curiouselectric/solarBauble/Solar Bauble - Instructions/SolarBauble_v2 _Schematic.pdf

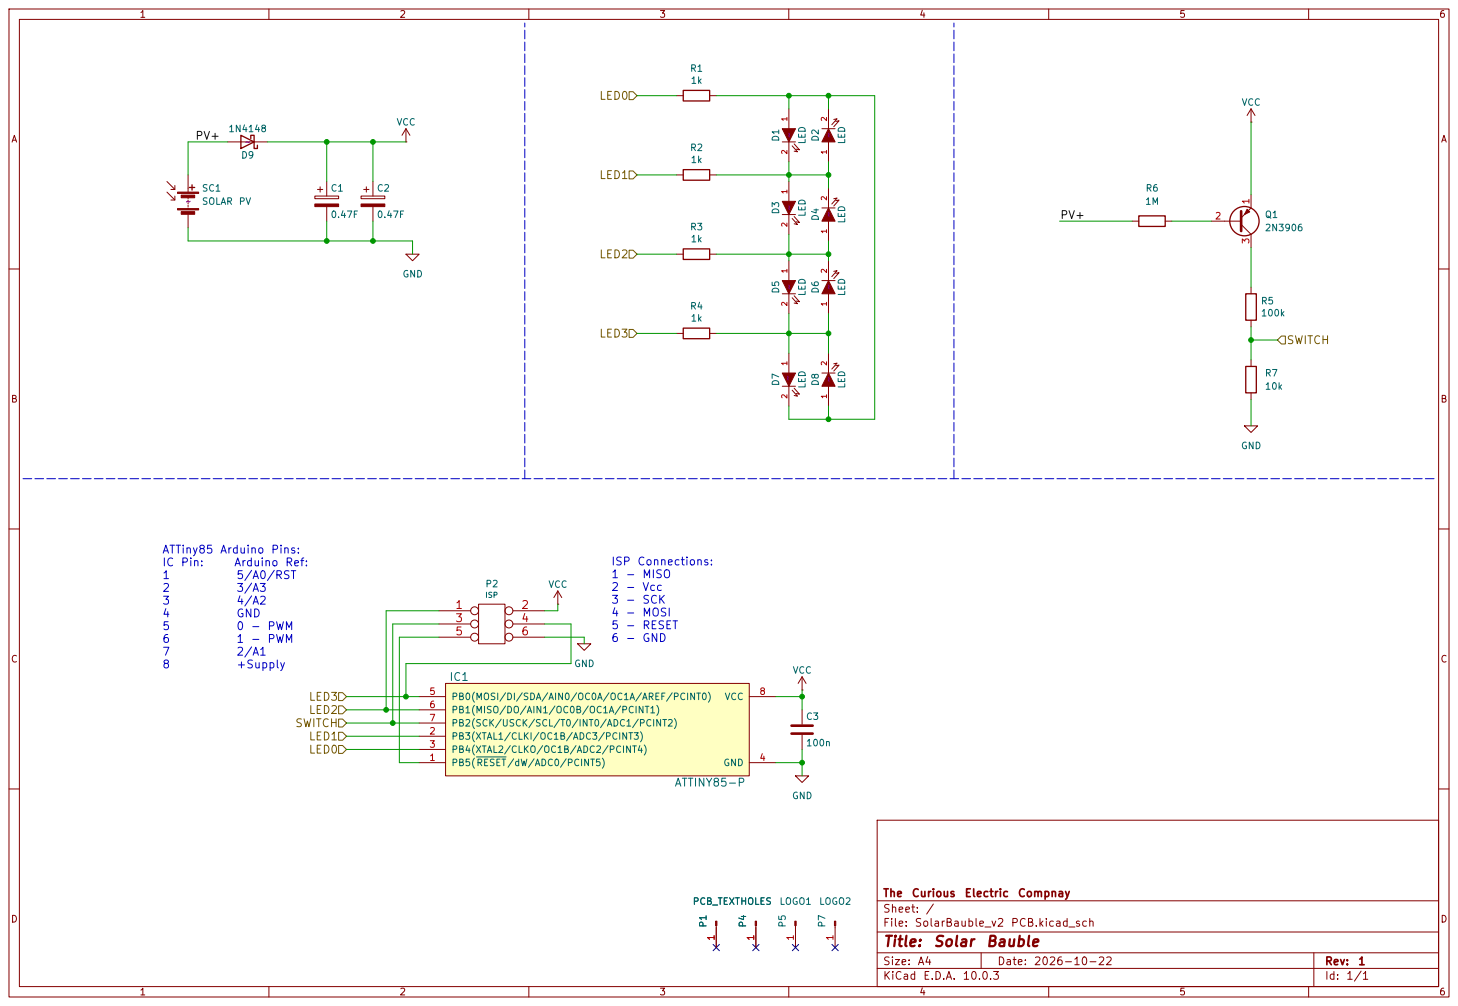
[picture p23: page 1]

The Curious Electric Compnay
Sheet: /
File: SolarBauble_v2 PCB.kicad_sch
Title: Solar Bauble

Size: A4 | Rev: 1
KiCad E.D.A. 10.0.3 | Id: 1/1
