curiouselectric/solarBauble/Solar Bauble - PCB/SolarBauble_v2 PCB.kicad_pcb

## KiCad design Solar Bauble - PCB/SolarBauble_v2 PCB.kicad_pcb (2026-10-22)

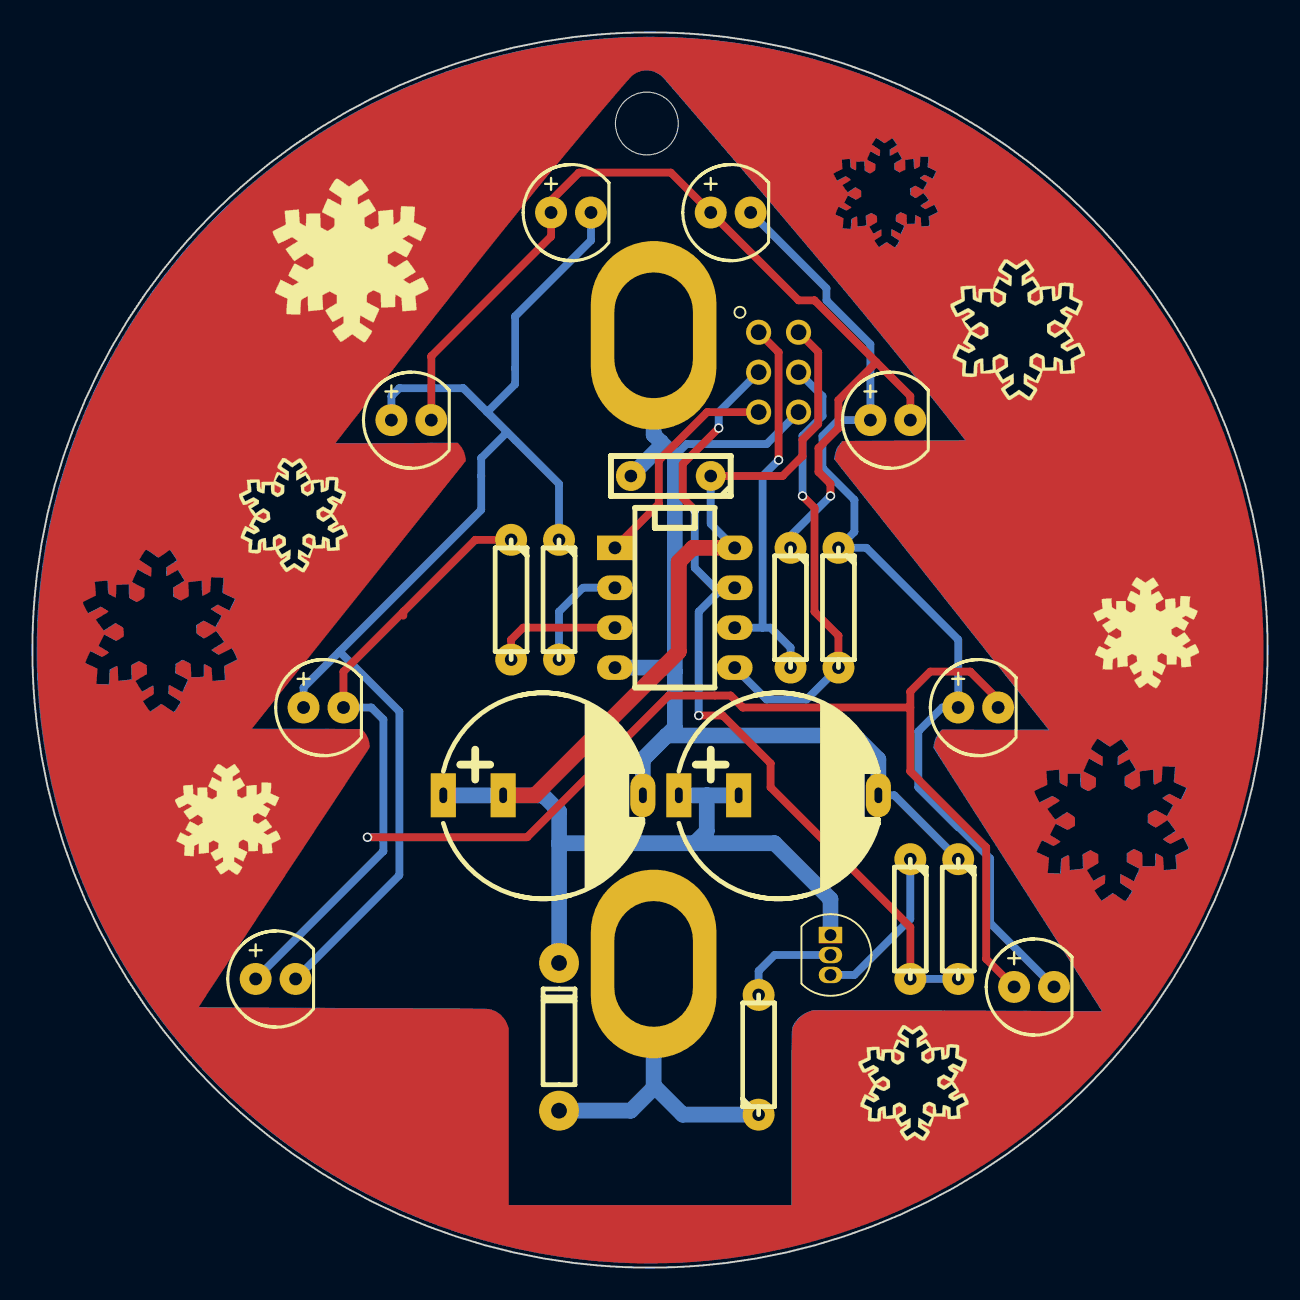
[picture p24: board SolarBauble_v2 PCB.kicad_pcb from above]

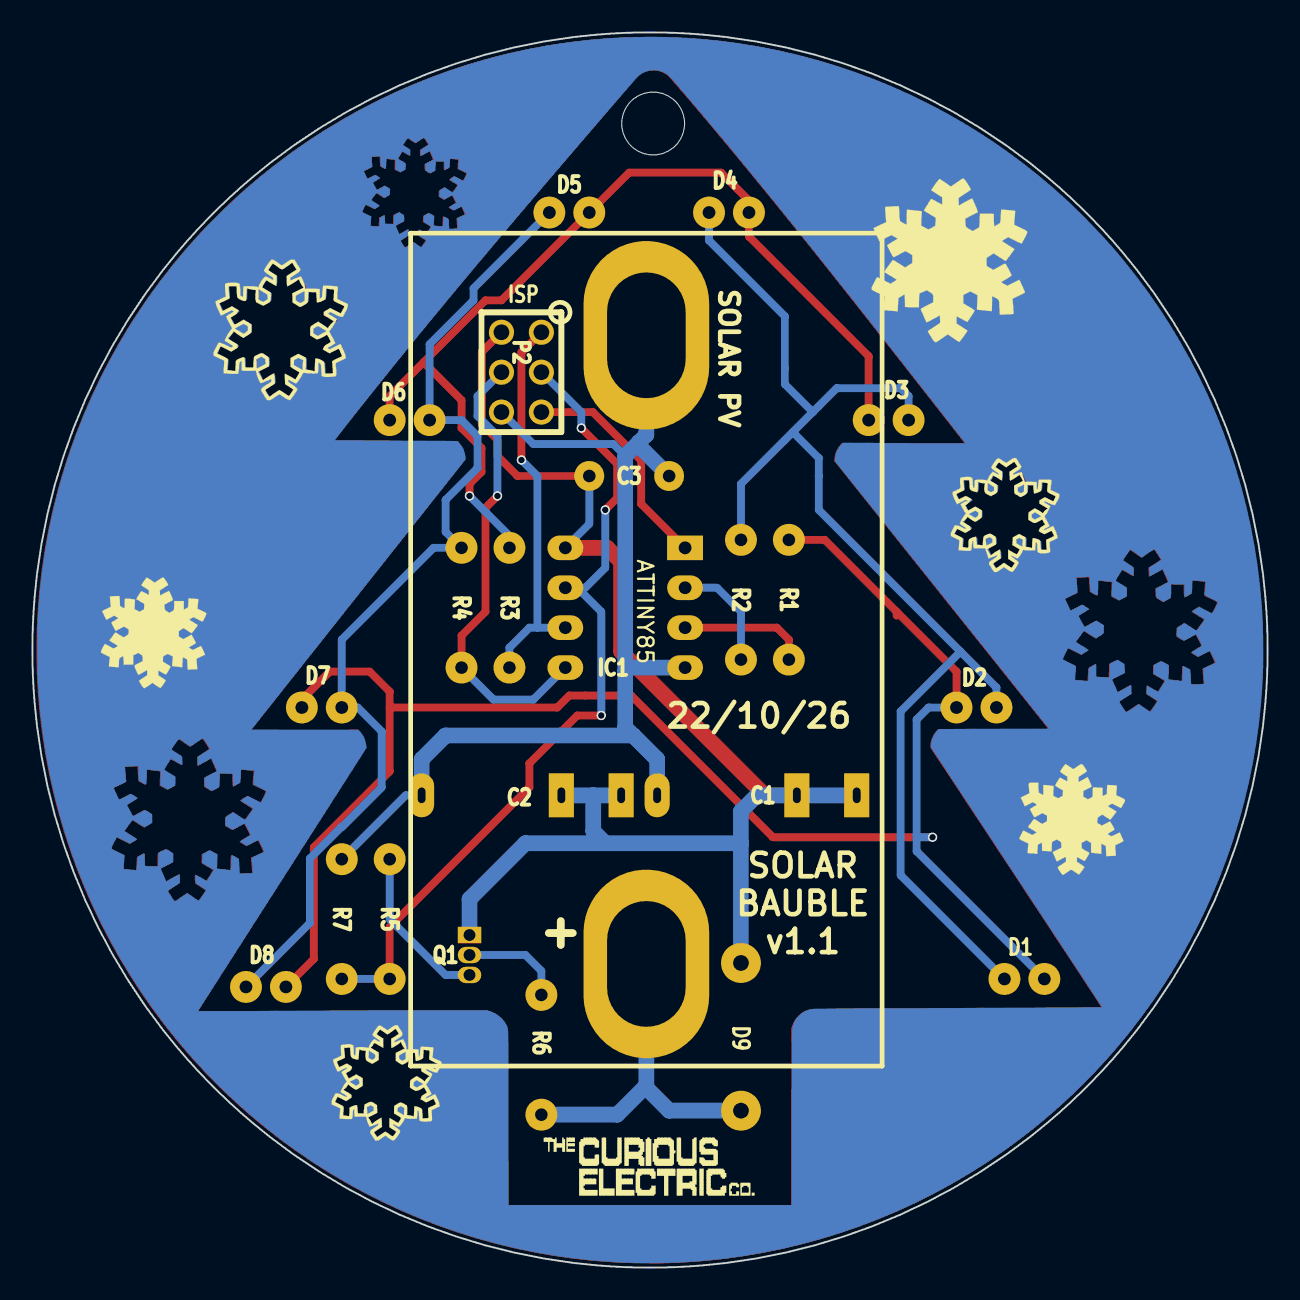
[picture p25: board SolarBauble_v2 PCB.kicad_pcb from below]

Board: 2 copper layers, 78.6 x 78.6 mm, 25 parts (2 on the bottom side), 15 nets.

Parts:
C1, C2: 0.47F; C_0_47F_SuperCap_2POS
C3: 100n; C1_wide_lg_pad_2
D1, D2, D3, D4, D5, D6, D7, D8: LED; LED-5MM_larg_pad
D9: 1N5819; TH_Diode_1_reversed
IC1: ATTINY85; DIP-8_300_ELL
P2: ISP; ISP_3x2
P4: HOLES; PCB_solarbauble_pcb_outline_tree_4_5
P7: LOGO2; TCEC_Words_13mm
Q1: 2N3906; TO-92_Inline
R1, R2, R3, R4: 1k; R3-LARGE_PADS_0_8_hole
R5: 100k; R3-LARGE_PADS_0_8_hole
R6, R7: 10k; R3-LARGE_PADS_0_8_hole
SC1: SOLAR PV; PV_53x30mm_Area

Connections:
/LED0: IC1.3 (PB4(XTAL2/CLKO/OC1B/ADC2/PCINT4)), R1.2
/LED1: IC1.2 (PB3(XTAL1/CLKI/OC1B/ADC3/PCINT3)), R2.2
/LED2: IC1.6 (PB1(MISO/DO/AIN1/OC0B/OC1A/PCINT1)), P2.1, R3.2
/LED3: IC1.5 (PB0(MOSI/DI/SDA/AIN0/OC0A/OC1A/AREF/PCI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), P2.4, R4.2
/PV+: D9.2 (A), R6.1, SC1.1 (+)
/SWITCH: IC1.7 (PB2(SCK/USCK/SCL/T0/INT0/ADC1/PCINT2)), P2.3, R5.2, R7.2
GND: C1.2, C2.2, C3.2, IC1.4 (GND), P2.6, R7.1, SC1.2 (-)
unnamed: D1.1 (A), D2.2 (K), D7.2 (K), D8.1 (A), R1.1
unnamed: D1.2 (K), D2.1 (A), D3.1 (A), D4.2 (K), R2.1
unnamed: D3.2 (K), D4.1 (A), D5.1 (A), D6.2 (K), R3.1
unnamed: D5.2 (K), D6.1 (A), D7.1 (A), D8.2 (K), R4.1
unnamed: IC1.1 (PB5(~RESET/dW/ADC0/PCINT5)), P2.5
unnamed: Q1.2 (B), R6.2
unnamed: Q1.3 (C), R5.1
VCC: C1.1, C2.1, C3.1, D9.1 (K), IC1.8 (VCC), P2.2, Q1.1 (E)
