curiouselectric/solarBauble/(commit log)

2026-10-22 initial commit of PCB and firmware
    [SolarBauble_v2 PCB-B_Cu.gbr, SolarBauble_v2 PCB-B_Mask.gbr, SolarBauble_v2 PCB-B_Silkscreen.gbr, SolarBauble_v2 PCB-Edge_Cuts.gbr, SolarBauble_v2 PCB-F_Cu.gbr, SolarBauble_v2 PCB-F_Mask.gbr, SolarBauble_v2 PCB-F_Silkscreen.gbr, SolarBauble_v2 PCB-job.gbrjob]
2026-10-22 update on instructions
    [SolarBauble_v2 PCB.kicad_sch]
2026-10-23 updated firmware to show when fully charged
2026-11-03 updated firmware
    [SolarBauble_v2 PCB.kicad_sch]
2026-11-05 updated code for lower power operation
    [SolarBauble_v2 PCB.kicad_sch]
